lucasantannaeng/SolarBoat-Telemetry/docs/ABSTRACT.md

# 📄 Bachelor Thesis Abstract & Metadata

## 🎓 Academic Thesis Details

- **Title (EN):** STUDY AND DEVELOPMENT OF AN AUTOMATED BILGE DRAINAGE SYSTEM WITH SLOSHING MITIGATION AND ULTRASONIC SENSING FOR SOLAR-POWERED VESSELS
- **Title (PT):** ESTUDO E DESENVOLVIMENTO DE UM SISTEMA AUTOMATIZADO DE DRENAGEM DE PORÃO COM MITIGAÇÃO DE SLOSHING E ACIONAMENTO INTELIGENTE BASEADO EM SENSORES ULTRASSÔNICOS
- **Author:** Luca Rodrigues Gomes de Sant'Anna
- **Advisor:** Prof. Fernando Antonio Trindade Campos, M.Sc.
- **Evaluation Board:** Prof. Flávio Félix Feliciano, D.Sc. & Prof. Josinira Antunes de Amorim, D.Sc.
- **Institution:** Instituto Federal de Educação, Ciência e Tecnologia Fluminense (IFF) - Campus Cabo Frio
- **Degree:** Bachelor of Engineering in Mechanical Engineering (2025)

---

## 🇬🇧 English Abstract

Bilge drainage is a critical element for the safety and operational efficiency of vessels, particularly small-sized solar-propelled ones, such as those used in the **Desafio Solar Brasil (DSB)**, since water accumulation in the bilge can compromise stability, buoyancy, and the electrical performance of the propulsion system. In this context, this work aims to study and develop the engineering design of an automated bilge drainage system, featuring mitigation of the sloshing phenomenon and intelligent actuation based on ultrasonic sensors. 

The proposal integrates knowledge of hydrodynamics, embedded automation, and electronic control, employing the **ESP32** microcontroller within an iterative design methodology focused on theoretical modeling, component specification, and firmware development. As a central part of the project, the stilling-well was dimensioned based on hydrodynamic criteria, adopting a $100\text{ mm}$ diameter, $30\text{ cm}$ height, and $6\text{--}8\text{ mm}$ perforations, aiming to balance energy dissipation and sensor reading stability. 

The theoretical analysis indicates the potential for significant improvement in measurement stability and noise reduction compared to systems without mitigation, while the hysteresis actuation logic ($9\text{ cm}$ ON / $3\text{ cm}$ OFF) with emergency float switch override ensures predictable drainage and prevents pump dry-running.

**Keywords:** marine automation; bilge drainage; sloshing; ultrasonic sensors; ESP32; solar boat racing; Desafio Solar Brasil.

---

## 🇧🇷 Resumo em Português

A drenagem de porão é um elemento crítico para a segurança e a eficiência operacional de embarcações, especialmente nas de pequeno porte e propulsão solar, como as utilizadas no **Desafio Solar Brasil (DSB)**, uma vez que o acúmulo de água pode comprometer a estabilidade, a flutuabilidade e o desempenho elétrico do sistema de propulsão. Nesse contexto, este trabalho tem como objetivo o estudo e o desenvolvimento do projeto de engenharia de um sistema automatizado de drenagem, com mitigação do fenômeno de *sloshing* e acionamento inteligente baseado em sensores ultrassônicos. 

A proposta integra conhecimentos de hidrodinâmica, automação embarcada e controle eletrônico, empregando o microcontrolador **ESP32** em uma metodologia de projeto iterativo focada na modelagem teórica, especificação de componentes e desenvolvimento de firmware. Como parte central do projeto, o *stilling-well* (poço de calma) foi dimensionado com base em critérios hidrodinâmicos, adotando diâmetro de $100\text{ mm}$, altura de $30\text{ cm}$ e perfurações de $6\text{--}8\text{ mm}$, visando equilibrar a dissipação de energia e a estabilidade de leitura do sensor. 

A análise teórica indica potencial para melhoria significativa na estabilidade das medições e redução de ruído em relação a sistemas sem mitigação, enquanto a lógica de acionamento por histerese ($9\text{ cm}$ liga / $3\text{ cm}$ desliga) com redundância de emergência via boia mecânica garante uma drenagem previsível e previne o funcionamento da bomba a seco.

**Palavras-chave:** automação naval; drenagem de porão; sloshing; sensores ultrassônicos; ESP32; Desafio Solar Brasil.
