lucasantannaeng/SolarBoat-Telemetry/(commit log)

2026-08-07 feat: release SolarBoat-Telemetry smart bilge drainage & telemetry system (TCC IFF Cabo Frio)
    [components_bom.csv]
2026-08-18 feat(firmware): implement non-blocking event loop, hardware watchdog, and UDP telemetry broadcast
    - Replace blocking delay() loops with non-blocking millis() state scheduling
    - Integrate ESP32 hardware watchdog timer (esp_task_wdt) with 10s timeout
    - Implement 1 Hz wireless UDP broadcast with packed TelemetryPacket payload
    - Add sensor fault detection and dry-run pump safety shutdown
    [config.h, main.cpp]
2026-08-19 feat(firmware): add median filtering, debounced float switch, calibrated adc and crc16 telemetry
