lucasantannaeng/SolarBoat-Telemetry/(notices)

Notices in the files:
README.md:
License: MIT
